mateo-ureche/Sensor-Ambiental-IoT-LTE-AWS/Documentacion/Flujo_Firmware.png

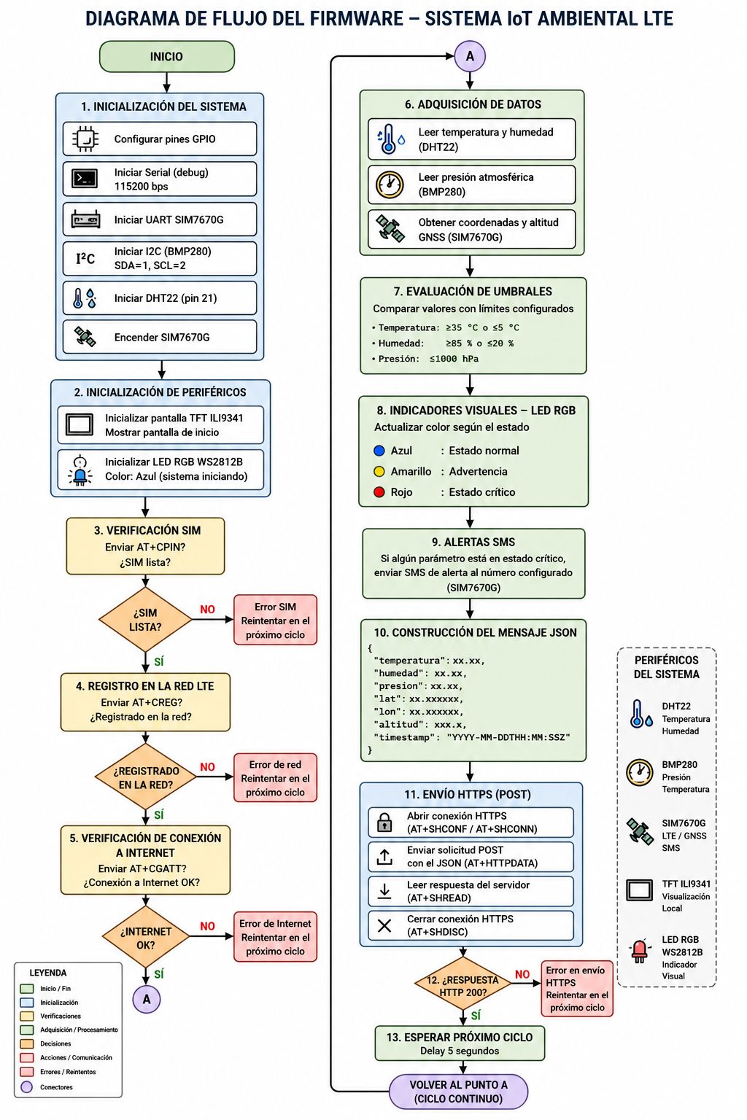
Documentacion/Flujo_Firmware.png
