mateo-ureche/Sensor-Ambiental-IoT-LTE-AWS/README.md

# Sensor-Ambiental-IoT-LTE-AWS
Proyecto para Comunicaciones realizado por: Mateo Ureche, Diana Taborda, Naeem Aroca y Carlos Sanchez
