mateo-ureche/Sensor-Ambiental-IoT-LTE-AWS/Documentacion/README.md

# Documentación

Esta carpeta contiene los documentos técnicos asociados al proyecto de monitoreo ambiental IoT-LTE basado en ESP32-S3, SIM7670G y servicios AWS.

## Contenido

- Informe final del proyecto.
- Diagramas de arquitectura.
- Diagramas de flujo del firmware.
- Modelo 3D del encapsulado.
- Diagrama Esquematico de conexiones
