mateo-ureche/Sensor-Ambiental-IoT-LTE-AWS/ESP32_Firmware/README.md

# Final System

Firmware final implementado para el nodo IoT.

Funciones integradas:

- DHT22
- BMP280
- GNSS
- LTE
- HTTPS
- AWS API Gateway
- DynamoDB
- Pantalla TFT ILI9341
- LED RGB
- Alertas SMS
