mateo-ureche/Sensor-Ambiental-IoT-LTE-AWS/Documentacion/Schematic_comunicaciones_2026-05-30.png

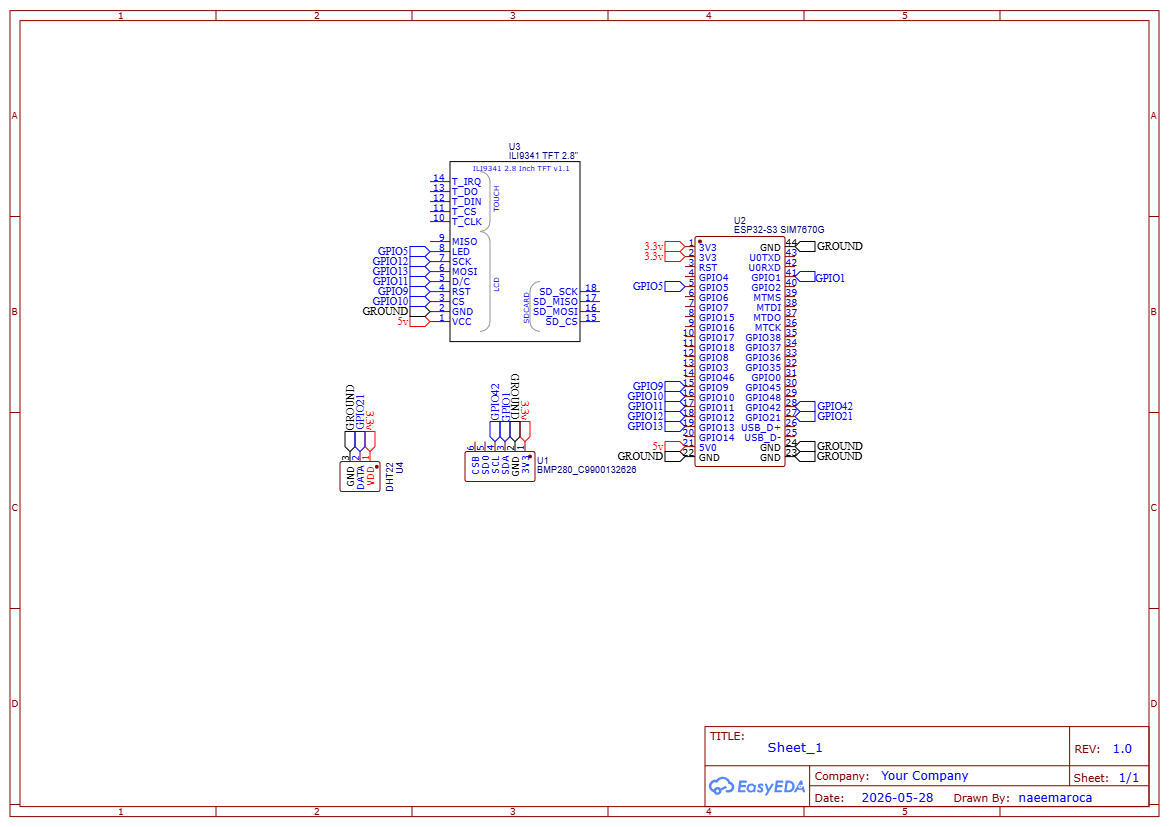
Documentacion/Schematic_comunicaciones_2026-05-30.png
